yacobUW/AutoRanging-Ohm-Meter/SRC/Images/PCB_ohm_meter.png

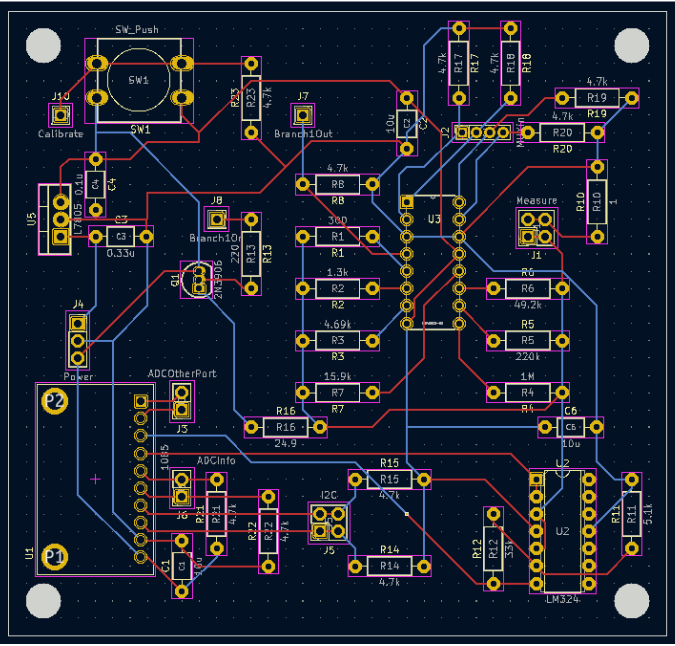
SRC/Images/PCB_ohm_meter.png
