yacobUW/AutoRanging-Ohm-Meter/SRC/Images/Schematic_ohm_meter.png

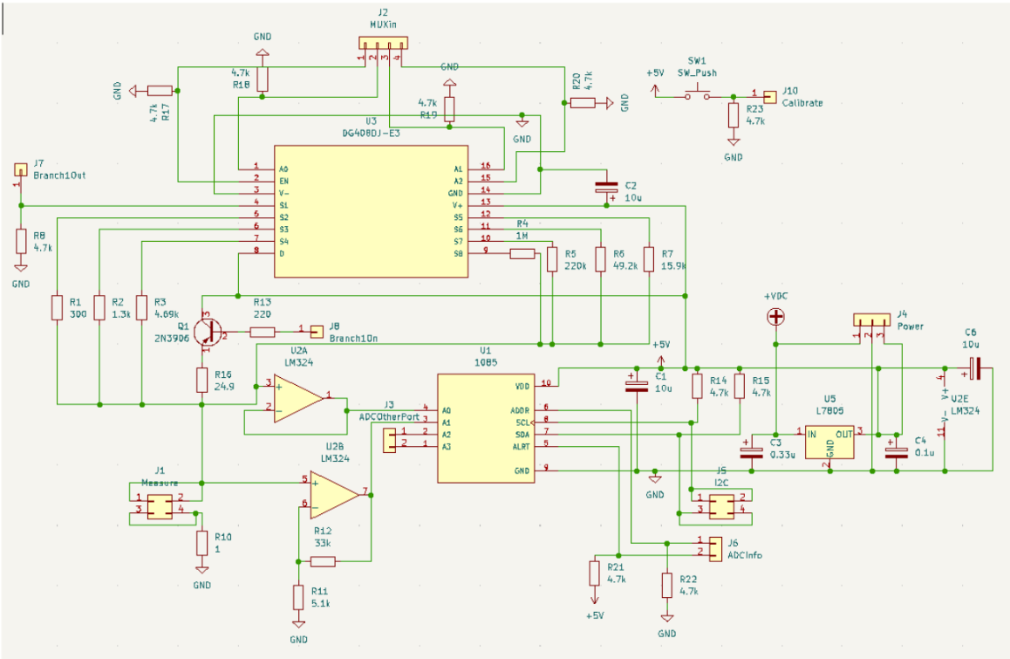
SRC/Images/Schematic_ohm_meter.png
