yacobUW/AutoRanging-Ohm-Meter/(commit log)

2023-06-24 Create Arduino
2023-06-24 Create Schematic
2023-06-27 Create Arduinocode
